hansj66/spar7-replacement-board/Firmware/README.md

Spar7
=====

Spar7 firmware

* If recompiling from scracth, use optimization O1
*	Make sure that the CKDIV8 fuse is NOT set.

If all else fails : rewire the #7 payout switch to be normally open and rewrite the code ;)
