hansj66/spar7-replacement-board/bill_of_materials.pdf

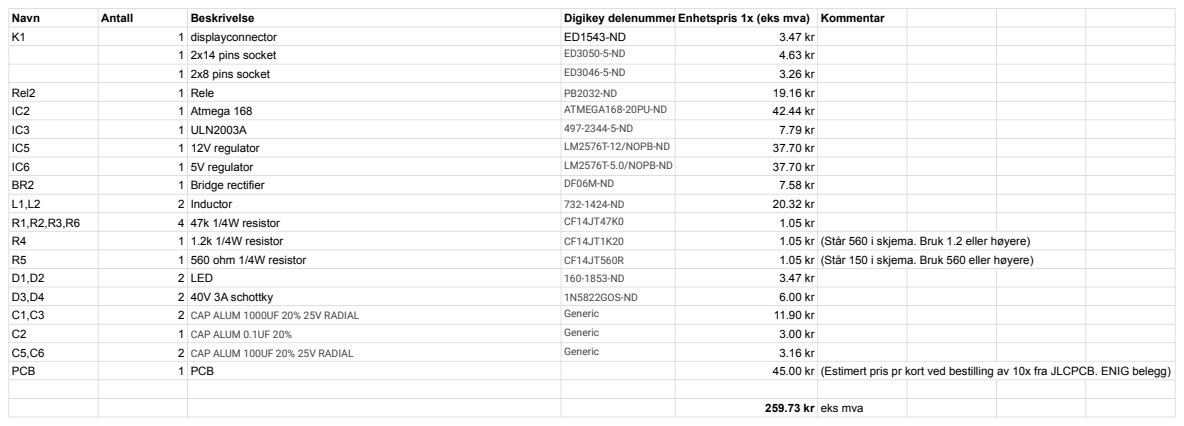
[picture p5: page 1]
Navn; Antall; Beskrivelse; Digikey delenummerEnhetspris 1x (eks mva) Kommentar; 1 displayconnector; 1 2x14 pins socket; 1 2x8 pins socket; Rel2; 1 Rele; 1 Atmega 168; ATMEGA168-20PU-ND; 1 ULN2003A; 1 12V regulator; LM2576T-12/NOPB-ND; 1 5V regulator; LM2576T-5.0/NOPB-ND; 1 Bridge rectifier; 2 Inductor; 4 47k 1/4W resistor; 1 1.2k 1/4W resistor; 1.05 kr (Står 560 i skjema. Bruk 1.2 eller høyere); 1 560 ohm 1/4W resistor; 1.05 kr (Står 150 i skjema. Bruk 560 eller høyere); 2 LED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

259.73 kr eks mva
