hansj66/spar7-replacement-board/Layout/pcb_layout.pdf

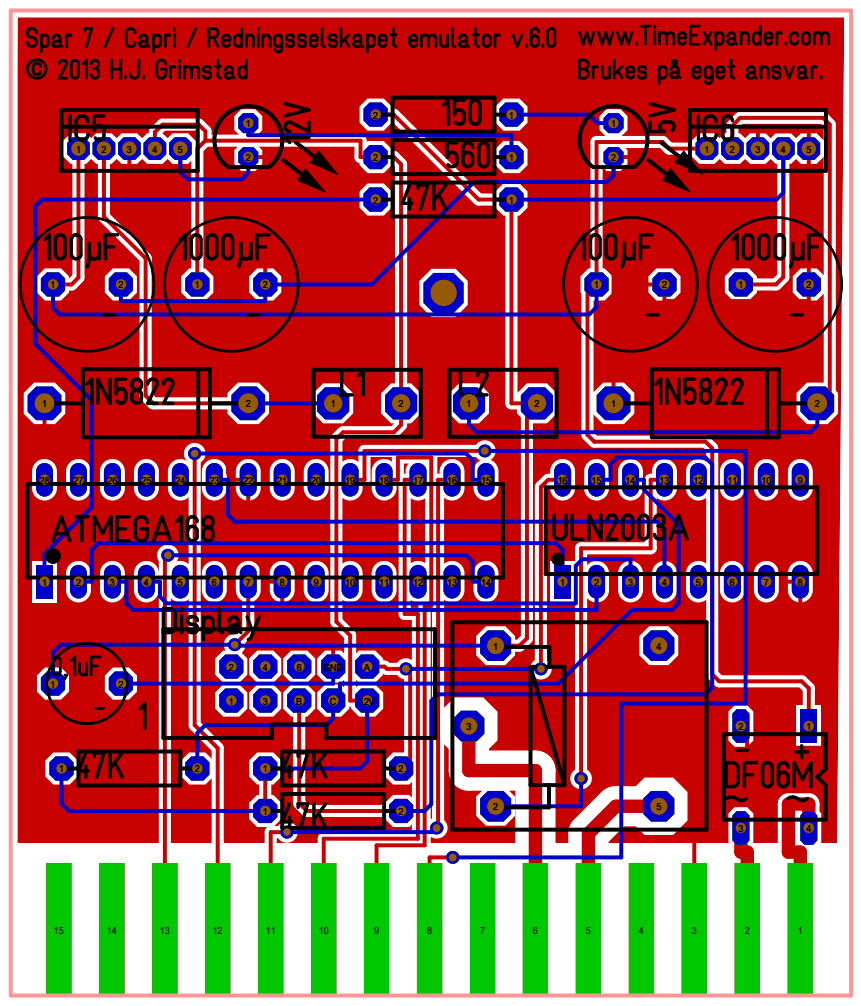
[picture p6: page 1]
6 GND
