hansj66/spar7-replacement-board/Schematic/schematic.pdf

47K

R6

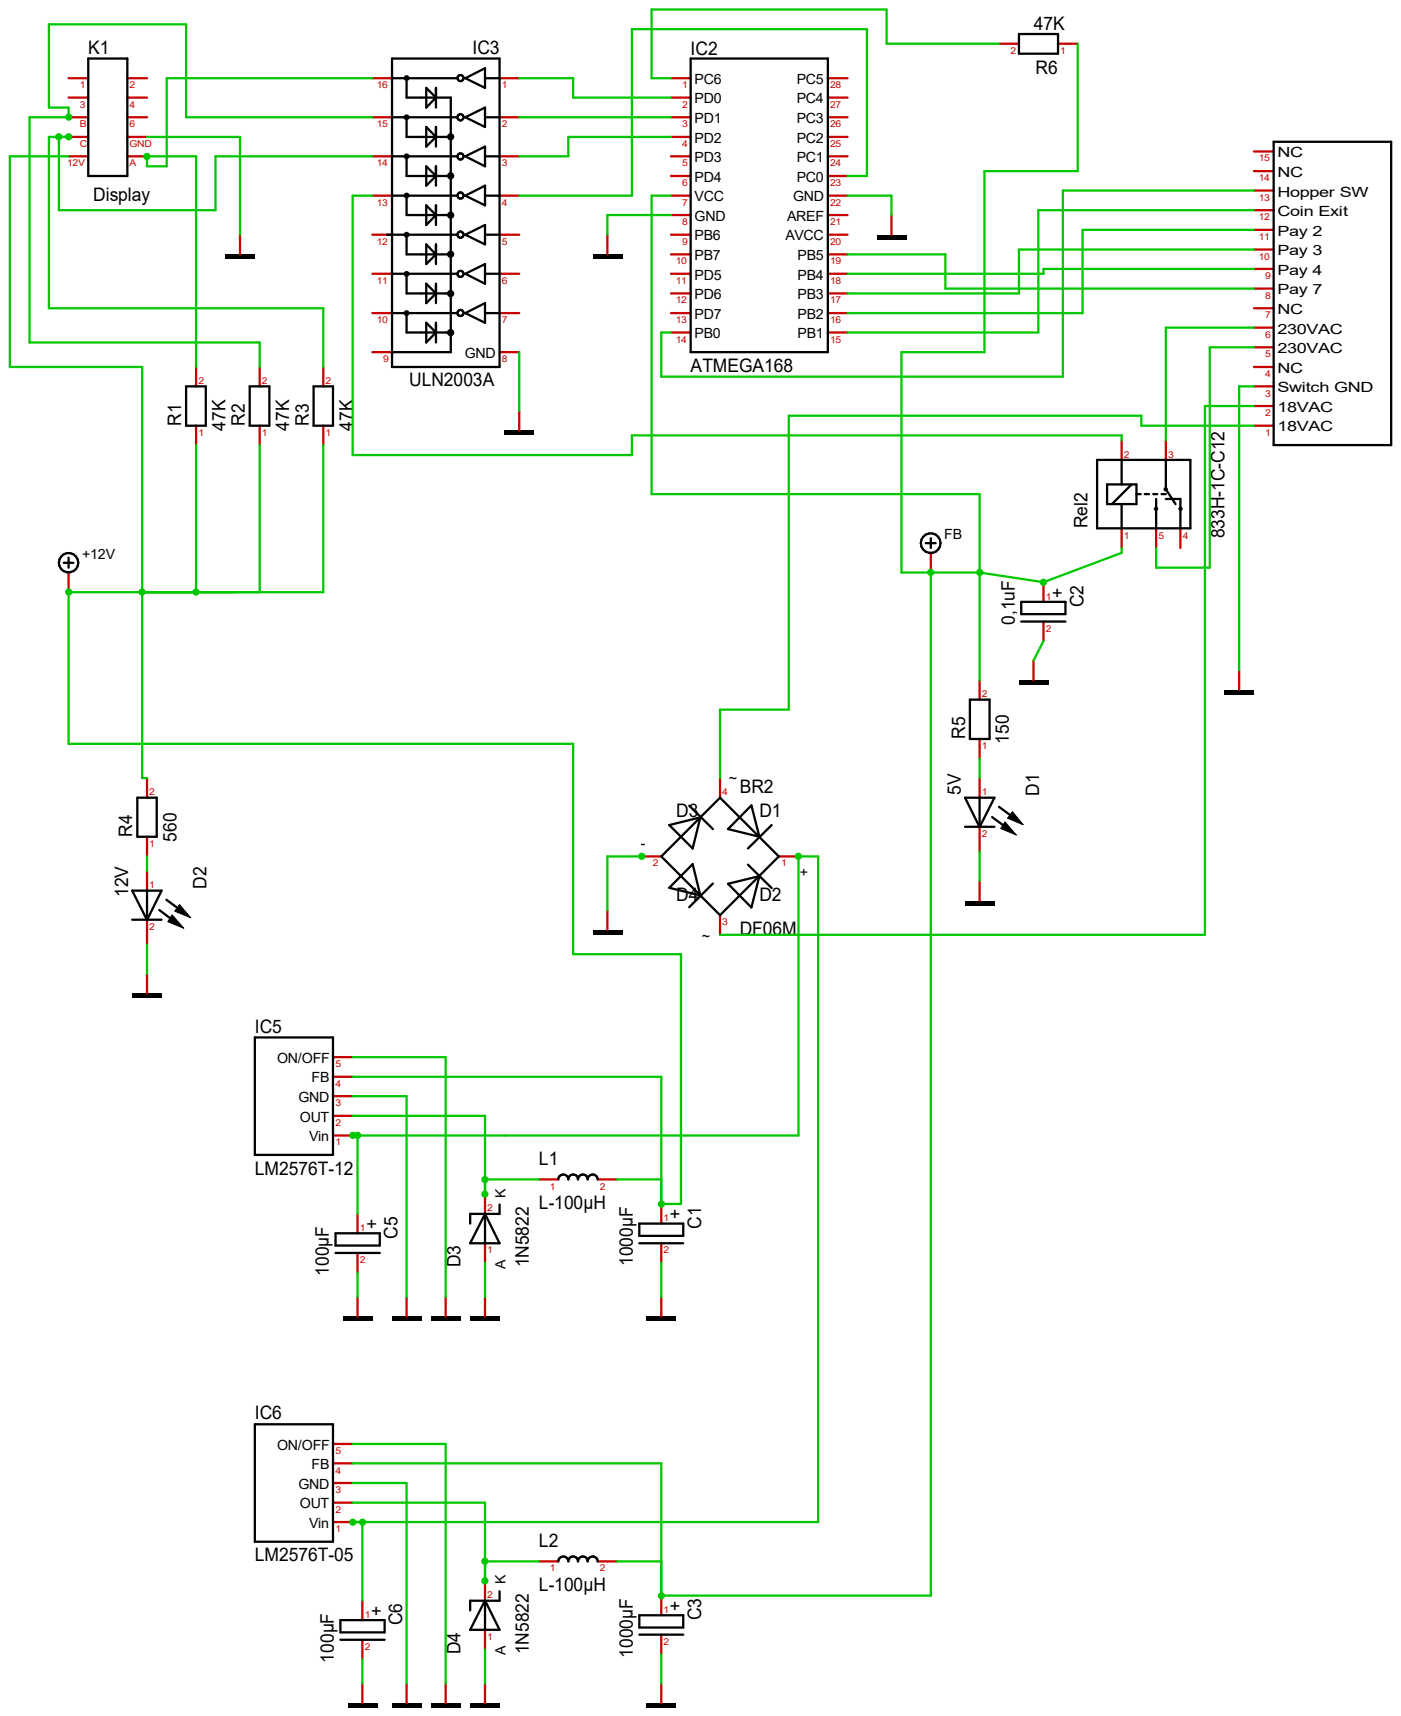
[picture p7: page 1]
